MYX-0211/rs485-gateway/README.md

# RS485 多传感器环境监测网关（STM32F407 + FreeRTOS）

基于 **STM32F407VGT6** 的工业 RS485 总线数据采集网关：以 **Modbus RTU 主站**轮询总线上的光照 / 温湿度传感器，经 **FreeRTOS 多任务**调度完成采集、显示、越限报警，并通过 **ESP-01S Wi-Fi** 接入 **MQTT（EMQX）** 上报与接收远程指令，支持 **OTA 双区固件升级**，是一套完整的嵌入式「采集 → 处理 → 交互 → 上云 → 可远程升级」工程实践。

     

> 配套作品：[pid-gateway](https://github.com/MYX-0211/pid-gateway)（电机 PID 速度闭环 + CAN 双向）——两项目形成「采集上云 + 实时控制」互补，覆盖工控常见双链路。

**English Overview**: FreeRTOS-based industrial RS485/Modbus-RTU sensor gateway on STM32F407VGT6 — polls lux/temp-humidity sensors over a half-duplex bus (DMA + idle-line framing, CRC16), drives OLED/key/buzzer, reports JSON over MQTT (EMQX) via an ESP-01S Wi-Fi module, accepts remote threshold commands, and supports OTA firmware upgrade with a dual-region bootloader plus external SPI-flash staging.

<p align="center">
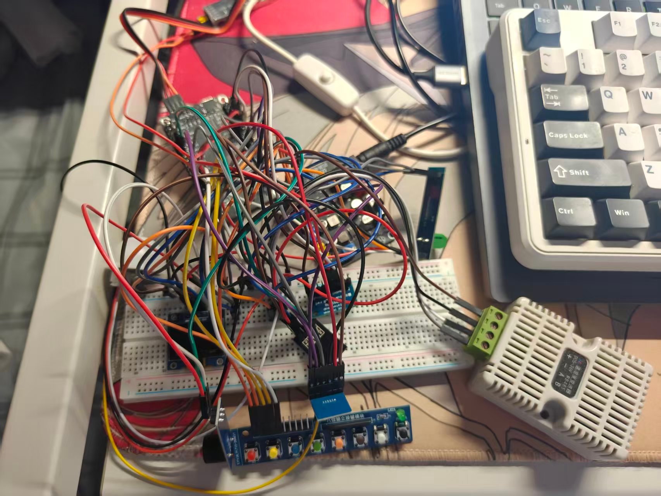
[picture p1: assets/screenshots/hardware_wiring.jpg]
RS485 网关实物接线：STM32F407 核心板 + MAX485 + OLED + ESP-01S + 温湿度传感器
  
</p>
<p align="center"><em>实物接线 —— 面包板上的完整链路：STM32F407 核心板 / MAX485 收发 / SSD1306 OLED / ESP-01S / 两路 RS485 传感器</em></p>

## 目录

- [系统架构](#系统架构)
- [功能特性](#功能特性)
- [硬件清单](#硬件清单)
- [软件设计要点](#软件设计要点)
- [MQTT 数据协议](#mqtt-数据协议)
- [OTA 固件升级](#ota-固件升级)
- [工程结构](#工程结构)
- [环境与构建](#环境与构建)
- [运行配置](#运行配置)
- [运行效果与实拍](#运行效果与实拍)
- [许可证](#许可证)

## 系统架构

```mermaid
flowchart TB
    subgraph BUS["RS485 总线 · USART1 + MAX485 · 9600 8N1"]
        direction LR
        S1["光照传感器<br/>B-RS-L30 · 地址 0x01"]
        S2["温湿度传感器<br/>HKDZ-SHT30 · 地址 0x02"]
    end

    MCU["STM32F407VGT6 @168MHz<br/>FreeRTOS V11.1.0"]

    subgraph TASKS["FreeRTOS 任务（数字为优先级）"]
        direction TB
        T1["vTaskSensor · 3 · 1s<br/>Modbus 轮询 → 报警判定 → 入队"]
        T2["vTaskLED · 2 · 200ms<br/>报警时三灯轮闪"]
        T3["vTaskNet · 1 · 5s<br/>MQTT 上报 / OTA 接收"]
        T4["vTaskOLED · 1 · 200ms<br/>Peek 最新帧刷新显示"]
        T5["vTaskKey · 1 · 10ms<br/>消抖 + 边沿检测"]
    end

    Q[("队列 深 1<br/>xQueueOverwrite")]
    OLED["SSD1306 OLED<br/>I2C1 · 400kHz"]
    ALARM["有源蜂鸣器 + 3×LED"]
    ESP["ESP-01S<br/>USART3 · 115200"]
    W25["W25Q64<br/>SPI1"]
    CLOUD["EMQX Broker<br/>Wi-Fi / TCP 1883"]

    S1 --> BUS
    S2 --> BUS
    BUS --> MCU
    MCU --> TASKS
    T1 --> Q
    Q --> T3
    Q --> T4
    T1 --> ALARM
    T2 --> ALARM
    T4 --> OLED
    T5 --> T4
    T3 --> ESP
    T3 --> W25
    ESP <-->|"JSON 上行 / 指令下行"| CLOUD
    CLOUD -.->|"OTA 固件下发（经 PC TCP:9000）"| W25

    style MCU fill:#dae8fc,stroke:#6c8ebf
    style Q fill:#fff2cc,stroke:#d6b656
    style CLOUD fill:#d5e8d4,stroke:#82b366
```

**串口资源分配**

| 外设 | 引脚 | 波特率 | 用途 |
|---|---|---|---|
| USART1 + MAX485 | PA9/PA10（DE=PA8） | 9600 8N1 | RS485 总线（Modbus RTU） |
| USART2 | PA2/PA3 | 115200 8N1 | printf 调试输出 |
| USART3 | PB10/PB11 | 115200 8N1 | ESP-01S Wi-Fi 模块 |
| I2C1 | PB6(SCL)/PB7(SDA) | 400kHz | SSD1306 OLED (0x78) |

## 功能特性

- **Modbus RTU 主站协议**：手写 CRC16-Modbus 校验；`0x03` 读保持寄存器完整事务（组帧 → 中断发送 → 空闲中断判帧接收 → 校验 → 大端解析），带完整错误码区分（无响应 / CRC 错 / 异常帧 / 地址不符）
- **RS485 半双工驱动**：DMA + 空闲中断（`HAL_UARTEx_ReceiveToIdle_DMA`）自动判帧，天然满足 Modbus RTU 3.5 字符帧间隔；DE 方向在 TC 中断精确切换，保证末位数据完整
- **FreeRTOS 多任务**：采集（最高优先级）/ LED 指示 / OLED 显示 / 按键 / 网络上报 五任务；采集任务以 `vTaskDelayUntil` 实现 1s 不漂移周期
- **任务间通信与同步**：深 1 队列 + `xQueueOverwrite` 广播最新数据帧；互斥锁保护 RS485 总线与 printf 输出；信号量实现发送/接收完成同步（含 ISR 安全释放）
- **温度越限报警**：三态判定 + 回差（hysteresis）防抖，按键可在线调节阈值并落 OLED 设置页
- **ESP-01S Wi-Fi 上报**：AT 指令完整状态机（退出透传 → 复位 → 探测 → STA 配网 → TCP 连接），UART 丢字节环境下健壮的多关键字匹配与安全重试
- **MQTT 双向通信**：经 ESP-01S 接入 EMQX，上行 5s 周期上报 JSON（光照/温湿度/报警），下行订阅 `rs485gw/cmd` 接收阈值设置与查询指令
- **OTA 固件升级**：Bootloader + 双区切换 + 外部 SPI Flash 暂存，CRC16 整包校验与回读校验，校验失败自动保持旧固件运行
- **参数掉电保存**：报警阈值写入外部 Flash 参数区，采用日志式追加写（避免频繁擦除），上电自动加载
- **工业传感器解析**：按厂商特殊编码解析温度（非标准 int16 补码），32 位光照跨寄存器大端合并；温湿度经 `0x04` 读输入寄存器

## 硬件清单

| 器件 | 型号/参数 | 说明 |
|---|---|---|
| 主控 | STM32F407VGT6 | 168MHz，1MB Flash / 192KB RAM |
| 总线收发 | MAX485 | RS485 半双工，PA8 方向控制 |
| 光照传感器 | B-RS-L30（Modbus，地址 0x01） | 寄存器 0x0002，32 位值 ÷1000 = Lux |
| 温湿度传感器 | HKDZ-SHT30-RS（Modbus，地址 0x02） | 寄存器 0x0000/0x0001，厂商特殊编码 |
| Wi-Fi 模块 | ESP-01S（ESP8266） | STA 模式，TCP Client |
| 外部 Flash | W25Q64（8MB SPI NOR） | OTA 固件暂存 + 参数区，SPI1（PB3/PB4/PB5，CS=PA4） |
| 显示 | SSD1306 OLED 0.96" | I2C，4 行 × 16 字符 |
| 交互 | 按键 ×3 / 有源蜂鸣器 / LED ×3 | 阈值调节、报警指示 |

## 软件设计要点

**任务划分与数据流**

| 任务 | 优先级 | 周期 | 职责 |
|---|---|---|---|
| `vTaskSensor` | 3 | 1s（绝对节拍） | RS485 总线锁内轮询两路传感器 → 报警判定 → 打包入队 |
| `vTaskLED` | 2 | 200ms | 报警时三灯轮闪 |
| `vTaskNet` | 1 | 5s | 取最新帧，经 ESP-01S TCP 上报；断线后台重连 |
| `vTaskOLED` | 1 | 200ms | Peek 最新帧刷新显示；设置页显示阈值调节界面 |
| `vTaskKey` | 1 | 10ms | 消抖 + 边沿检测，KEY1 切设置页 / KEY2/3 调阈值 |

**体现工程能力的关键处理**

- **RS485 总线互斥**：Modbus 事务全程持锁，锁内只做单次最短事务、锁外重试，避免与后续 Shell 等总线使用者冲突
- **HAL timebase 修复**：CubeMX 生成的 TIM6 中断未在 NVIC 使能，曾导致 `HAL_Delay` 卡死；手动「清 pending → 优先级 0 → 使能」根治（该中断不触碰任何 RTOS API，优先级 0 安全）
- **printf 重定向加锁**：`fputc` 经互斥锁串行化到 UART2，多任务并发打印不交错；调度器启动前自动降级裸发
- **栈与堆防护**：使能 `configCHECK_FOR_STACK_OVERFLOW` 与 malloc 失败钩子，爆栈/堆耗尽时打印任务名并停机，便于定位
- **ESP 初始化异步化**：配网与 TCP 重试（最坏数十秒）放入 `vTaskNet` 后台执行，调度器与 OLED 立即启动，不被网络阻塞
- **ESP 接收通道改造**：早期逐字节阻塞轮询在高优先级任务抢占时会丢字节（USART 无 FIFO，1ms 内可到 11 字节）。改为 DMA + 空闲中断 + 信号量后彻底解决，并补上错误恢复回调（`HAL_UART_ErrorCallback` 未实现时通道会永久静默）
- **OTA 顺序设计**：先在外部 Flash 暂存区完整收齐并校验通过，才动 APP 区 —— 任何时刻断电，至少有一份完整固件；搬运中断也能在下次上电自动重试

## MQTT 数据协议

设备经 ESP-01S 接入 EMQX，用两个主题完成双向通信：

| 主题 | 方向 | QoS | 说明 |
|---|---|---|---|
| `rs485gw/data` | 上行（设备 → 服务端） | 0 | 5 s 周期数据上报，同时承载指令回执 `ack` |
| `rs485gw/cmd` | 下行（服务端 → 设备） | 0 | 阈值设置 / 状态查询 / OTA 触发 |

**上行数据字段**

| 字段 | 类型 | 含义 |
|---|---|---|
| `seq` | uint | 帧序号自增，服务端据此判缺帧 / 重帧（断网补传的前置条件）|
| `up` | uint | 设备自开机毫秒数，用于判断数据新鲜度，与 `seq` 互相印证 |
| `lux` | float | 光照度（Lux）|
| `temp` | float | 温度（℃）|
| `humi` | float | 湿度（%RH）|
| `alarm` | 0 / 1 | 温度越上限报警标志（湿度只采集上报，不参与判定）|

**下行命令**

| 命令 | 回执 | 说明 |
|---|---|---|
| `{"cmd":"set_hi","v":30.0}` | `{"ack":"set_hi","hi":30.0}` | 远程修改报警上限，越界自动钳位；回差同步为 `v - 1.0`，并走与按键同一条掉电保存路径 |
| `{"cmd":"get"}` | `{"ack":"get","hi":…,"lux":…,"temp":…,"humi":…,"alarm":…}` | 查询当前阈值与最新一帧数据，改完可立刻回读，形成闭环验证 |
| `{"cmd":"ota_recv"}` | 串口打印 `STAGED OK` | 断开 MQTT → 连接 PC 的 `TCP:9000` 接收固件 → 校验通过后复位，由 Bootloader 搬运 |
| `{"cmd":"ota"}` / `{"cmd":"ota_bad"}` | `{"ack":"ota","r":0}` | OTA 自测：把当前 APP 写入暂存区；`ota_bad` 故意写错 CRC，用于验证「校验不过时拒绝搬运、旧固件照常运行」 |

> 未识别命令只打印日志并忽略，非法输入不会影响设备运行。`set_hi` 与按键任务可能并发写同一阈值，本工程按「最后写入者胜」处理：两侧都只做「赋值 + 钳位」而不做读-改-写，且 float 单次写入在 Cortex-M4 上是原子的，不会出现撕裂值。

**MQTTX 收发实测**（上行 5 s 一条、`seq` 连续；底部为下行 `ota_recv` 指令）

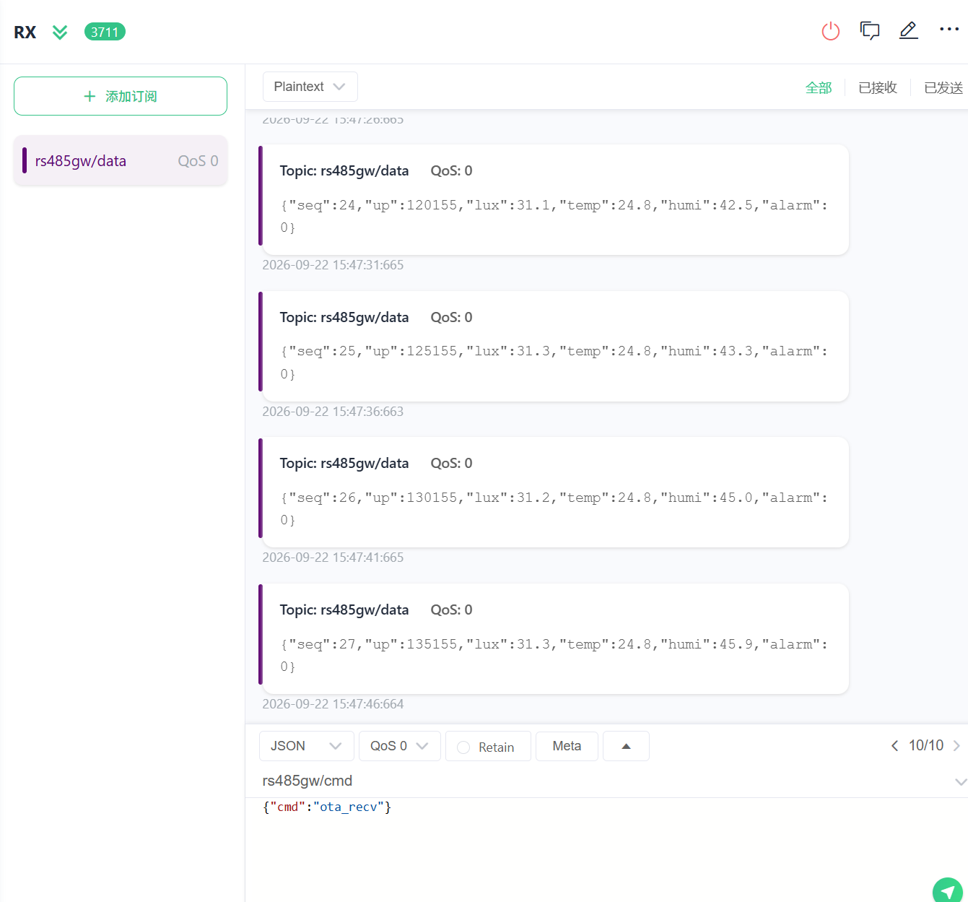
[picture p2: assets/screenshots/mqttx_report.png]
MQTTX 收发实测


## OTA 固件升级

采用 **Bootloader 双区 + 外部 Flash 暂存** 方案，全程约 11 秒（48 KB 固件）。

### 升级时序

```mermaid
sequenceDiagram
    autonumber
    participant PC as PC端 ota_sender.py
    participant ESP as ESP-01S
    participant APP as APP (vTaskNet)
    participant FL as W25Q64 暂存区
    participant BOOT as Bootloader

    Note over APP: 收到 MQTT 的 ota_recv 指令
    APP->>ESP: AT+MQTTDISCONNECT（与 MQTT 分时复用）
    APP->>FL: 整区擦除（64 KB 块擦，约 1.2 s）
    APP->>ESP: AT+CIPSTART 连接 PC:9000
    PC-->>ESP: TCP 建连
    loop 逐行下发 hex 编码固件
        PC->>ESP: hex 数据行 + CRLF
        ESP->>APP: +IPD 数据帧
        APP->>APP: 跳过前缀 → hex 解码 → 累加 CRC16
        APP->>FL: 写入暂存区
    end
    PC->>APP: 结束帧 END size crc
    APP->>APP: 比对字节数与整包 CRC
    APP->>FL: 回读校验 → 写头部（magic/fw_size/fw_crc/ver）
    Note over APP: 提示后由用户复位

    Note over BOOT: 复位后由 Bootloader 接管
    BOOT->>FL: 读头部
    BOOT->>FL: 校验整包 CRC
    alt CRC 通过
        BOOT->>BOOT: 擦 APP 区 → 按扇区搬运 → 回读校验
        BOOT->>FL: 清除升级标志
        BOOT->>APP: 跳转到 APP 执行
    else CRC 不通过
        BOOT->>APP: 直接跳转（旧固件照常运行）
    end
```

### Flash 分区

```mermaid
flowchart LR
    subgraph MCU["STM32F407 内部 Flash · 1 MB"]
        direction TB
        B["Bootloader<br/>0x08000000<br/>64 KB"]
        A["APP<br/>0x08010000<br/>704 KB"]
        U["未使用"]
    end

    subgraph W25["W25Q64 外部 SPI Flash · 8 MB"]
        direction TB
        S["固件暂存区<br/>0x000000<br/>1 MB"]
        K["备份区（预留）<br/>0x100000<br/>1 MB"]
        R["未使用"]
    end

    PC["PC<br/>ota_sender.py"] -->|"TCP 下发"| S
    S -->|"Bootloader 搬运"| A
    B -->|"校验通过后跳转"| A

    style B fill:#ffe6cc,stroke:#d79b00
    style A fill:#d5e8d4,stroke:#82b366
    style S fill:#dae8fc,stroke:#6c8ebf
    style K fill:#f5f5f5,stroke:#999999
    style R fill:#f5f5f5,stroke:#999999
    style U fill:#f5f5f5,stroke:#999999
```

| 区域 | 地址 | 大小 | 用途 |
|---|---|---|---|
| Bootloader | `0x08000000` | 64 KB | 升级搬运（裸机，不复用 APP 代码）|
| APP | `0x08010000` | 704 KB | 应用固件 |
| W25Q64 暂存区 | `0x000000` | 1 MB | 待搬运的新固件 |
| W25Q64 备份区 | `0x100000` | 1 MB | 预留（回滚用）|

**关键设计**

- **升级期间不影响运行**：固件先落在外部 SPI Flash，不占用内部 Flash —— 写入期间 APP 照常采集上报
- **刷坏不变砖**：暂存区校验不通过时 Bootloader 不碰 APP 区，旧固件继续运行
- **顺序保证**：擦除在开始接收之前一次性完成（擦内部 Flash 时同 Bank 取指 stall，边收边擦会丢帧）
- **回读校验**：搬运后把 APP 区读回来重新算 CRC，不依赖"写入成功"的返回值

**使用方法**

```bash
# 0. 先生成待下发的固件 bin（Doc/*.bin 不入库，需本地自行导出）
fromelf --bin --output=Doc/app_v1.bin MDK-ARM/rs485_gateway/rs485_gateway.axf

# 1. PC 上启动下发脚本（监听 9000）
python tools/ota_sender.py Doc/app_v1.bin
#    或直接双击 tools/run_ota_sender.bat（自动探测可用 Python，缺省发送 Doc/app_v1.bin）

# 2. 设备收到 MQTT 指令后断开 MQTT、连上 PC 并接收固件
#    MQTTX 向 rs485gw/cmd 发布： {"cmd":"ota_recv"}

# 3. 接收完成并校验通过后复位，Bootloader 自动搬运并跳转
```

> `fromelf` 随 Keil MDK 一同安装；也可在 Keil 的 Target Options → User → After Build 中挂上该命令，编译后自动导出 bin。

**实测性能**（48 KB 固件）

| 环节 | 耗时 |
|---|---|
| 擦除暂存区 704 KB（64 KB 块擦）| ≈ 1.2 s |
| 接收 48 KB（hex over UART @115200）| ≈ 8.7 s |
| Bootloader 校验 + 擦 APP 扇区 + 搬运 + 回读 | ≈ 1.0 s |
| **设备侧合计** | **≈ 11 s** |

> 接收环节受 UART 速率限制（hex 编码使传输量翻倍）；如需提速可提高 USART3 波特率或改用二进制传输。

### 串口实测日志

一次完整的 OTA 升级（48 KB 固件，`ver=2`）：PC 侧 TCP 建连后约 8.8 s 收完，回读 CRC 与接收 CRC 完全一致，暂存落盘成功后才提示复位。

```text
[OTA] disconnecting MQTT before TCP transfer...
[OTA] erasing stage area (704 KB)...
[OTA] stage erased
[OTA] TCP connected to 192.168.1.100:9000, receiving...
[OTA] recv 8192 B
[OTA] recv 16384 B
[OTA] recv 24576 B
[OTA] recv 32768 B
[OTA] recv 40960 B
[OTA] recv 49152 B
[OTA] END frame: size=49152 crc=0x6F75
[OTA] readback crc=0x6F75 recv crc=0x6F75
[OTA] recv done: got 49152 B, exp 49152 B; crc got 0x6F75 exp 0x6F75
[OTA] STAGED OK: size=49152 crc=0x6F75 ver=2 -> reboot to apply
[OTA] TCP closed
[OTA] recv result=0, MQTT will reconnect
[ESP] reconnecting...
```

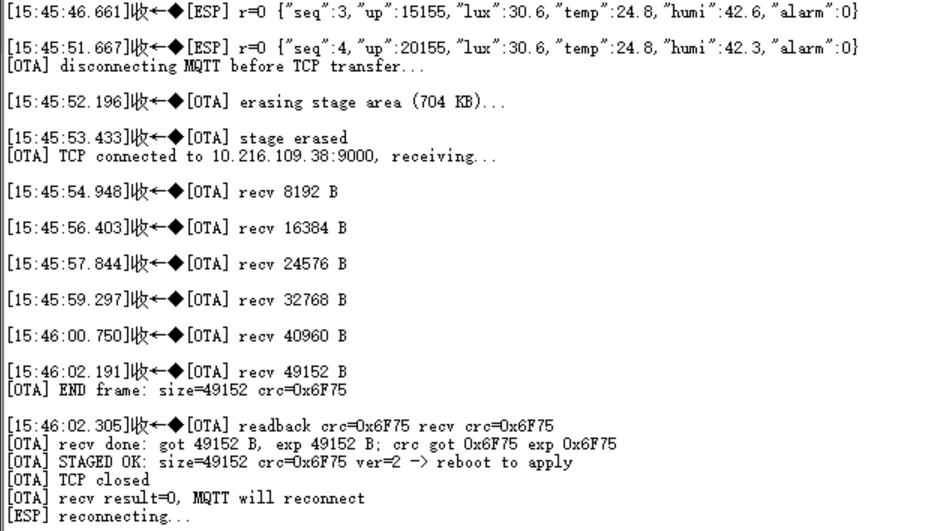
[picture p3: assets/screenshots/ota_uart_log.png]
OTA 升级串口日志


## 工程结构

```
rs485_gateway/
├── Bootloader/
│   └── boot_main.c             # OTA Bootloader（裸机，双区升级搬运）
├── Core/                       # 应用代码（CubeMX + 自研）
│   ├── Inc/
│   │   ├── main.h              # 引脚宏定义（按键/LED/RS485/蜂鸣器）
│   │   ├── modbus.h            # Modbus RTU 主站接口
│   │   ├── rs485.h             # RS485 半双工驱动接口
│   │   ├── esp01s.h            # ESP-01S Wi-Fi 驱动接口
│   │   ├── w25q64.h / spi.h    # 外部 SPI Flash 驱动 / SPI1 初始化
│   │   ├── param.h             # 报警阈值掉电保存
│   │   ├── ota.h               # OTA 共享定义（分区/头部结构/CRC16）
│   │   ├── oled.h / oledfont.h # SSD1306 驱动 / 8×16 字库
│   │   └── FreeRTOSConfig.h    # FreeRTOS 裁剪配置
│   └── Src/
│       ├── main.c              # 应用层：任务创建 + 业务逻辑 + OTA 接收
│       ├── modbus.c            # CRC16 + 寄存器读事务（0x03 / 0x04）
│       ├── rs485.c             # UART+DMA 收发、方向切换、回调
│       ├── esp01s.c            # AT 指令状态机、TCP 上报、MQTT、取流接口
│       ├── w25q64.c / spi.c    # Flash 读写擦除 / SPI1 外设
│       ├── param.c             # 参数区日志式追加写
│       ├── oled.c              # OLED 底层 I2C 时序
│       └── usart.c / i2c.c ... # CubeMX 外设初始化
├── FreeRTOS/                   # FreeRTOS V11.1.0 精简内核
│   ├── Inc/                    # 内核头文件
│   └── Src/                    # list/tasks/queue/port/heap_4 等
├── Drivers/                    # CMSIS + STM32F4xx HAL 库
├── tools/                      # PC 侧辅助脚本
│   ├── ota_sender.py           # OTA 固件下发（PC 侧 TCP Server）
│   ├── run_ota_sender.bat      # 双击启动器（自动探测可用的 Python 解释器）
│   ├── after_cubemx.py         # CubeMX 重新生成后的配置恢复脚本
│   ├── check_printf_ascii.py   # 校验 printf 字面量不含非 ASCII（AC5 按 GBK 解析源码）
│   └── strip_ai_comment_style.py # 清理 C 注释里的 Markdown / emoji 残留
├── Doc/
│   └── debug-log.md            # 调试复盘（6 条真实踩坑，已入库；其余手册/视频为本地资料）
├── assets/                     # 演示视频 + 运行实拍截图
│   ├── demo.mp4 / demo_cover.jpg
│   └── screenshots/            # 硬件接线 / OLED / MQTTX / OTA 串口日志
├── MDK-ARM/rs485_gateway.uvprojx   # Keil 工程（APP / BOOT 双 Target）
├── rs485_gateway.ioc           # CubeMX 配置（可重新生成）
├── LICENSE                     # MIT
└── README.md
```

## 环境与构建

| 工具 | 版本 | 说明 |
|---|---|---|
| Keil MDK | μVision5（工程按 **ARM Compiler 5 / AC5** 配置，`uAC6=0`） | 打开 `MDK-ARM/rs485_gateway.uvprojx` 直接编译 |
| STM32CubeMX | 任意支持 F4 的版本 | 可选：修改 `.ioc` 重新生成外设代码 |
| 烧录 | ST-Link / J-Link | Keil 下载按钮直接烧录 |

构建步骤：

1. 安装 Keil MDK5 与 STM32F4 器件支持包（Device Family Pack）
2. 打开 `MDK-ARM/rs485_gateway.uvprojx`
3. FreeRTOS 内核源码已内置于仓库（`FreeRTOS/`），无需额外安装或手动添加路径
4. 按需切换工程内两个 Target 分别编译：`rs485_gateway`（APP，`0x08010000`）与 `BOOT`（Bootloader，`0x08000000`）
5. 编译（F7）→ 下载（F8）→ 复位运行

> 注：工程为 CubeMX 生成结构，`Core` 中带有 `USER CODE` 标记的代码段可被 CubeMX 保留，便于后续重新生成外设代码。重新生成后如遇外设配置被覆盖，可参考 `tools/after_cubemx.py` 恢复。

## 运行配置

烧录前修改 `Core/Src/main.c` 顶部宏（仓库内均为占位符，不含任何真实凭据）：

```c
#define WIFI_SSID    "YOUR_SSID"       /* 2.4G 热点名（ESP-01S 只支持 2.4G，勿填 5G） */
#define WIFI_PWD     "YOUR_PASSWORD"   /* 热点密码 */
/* USE_MQTT=1 -> MQTT broker：填 PC 的 IP，由 PC 上的 portproxy 转发到 EMQX 虚拟机
 * USE_MQTT=0 -> 裸 TCP：填 PC 网络调试助手的地址，端口与助手的 TCPServer 一致 */
#define SERVER_IP    "192.168.1.100"   /* PC 在该网络下的 IP（换网络必须同步改，用 ipconfig 查） */
#if USE_MQTT
#define SERVER_PORT  1883              /* MQTT broker 端口 */
#else
#define SERVER_PORT  8000              /* PC 网络调试助手 TCPServer 端口 */
#endif
```

上报链路由 `Core/Inc/esp01s.h` 中的 `USE_MQTT` 开关切换（默认 `1` = 走 MQTT），三处端口用途不同、不要混淆：

| 用途 | 端口 | 定义位置 | 对端 |
|---|---|---|---|
| MQTT 上行 / 指令下行（`USE_MQTT=1`） | 1883 | `main.c` `SERVER_PORT` | EMQX broker |
| 裸 TCP 上报（`USE_MQTT=0`） | 8000 | `main.c` `SERVER_PORT` | PC 网络调试助手（TCP Server 模式） |
| OTA 固件下发 | 9000 | `main.c` `OTA_SRV_PORT` | PC `tools/ota_sender.py` |

- ESP-01S 仅支持 **2.4G** Wi-Fi；公共热点若需网页/短信认证（Portal）无法直连，请换普通热点
- 换网络后 `SERVER_IP` 需同步改为 PC 在该网络下的实际 IP；PC 端使用任意网络调试助手时必须开 **TCP Server 模式**、端口与 `SERVER_PORT` 一致
- 串口调试输出在 **UART2（115200 8N1）**；数据 5 s 一条，打印内容与 MQTT 上行 JSON 完全一致：
  ```
  [ESP] r=0 {"seq":3,"up":15155,"lux":30.6,"temp":24.8,"humi":42.6,"alarm":0}
  ```

> 调试复盘（timebase 卡死 / printf 加锁 / ESP 异步化等 6 条真实踩坑）见 [Doc/debug-log.md](Doc/debug-log.md)。

## 运行效果与实拍

**OLED 显示**（SSD1306，4 行 × 16 字符；正常页 200 ms 刷新，设置页由 KEY1 进入、KEY2/KEY3 调节）

| 正常页 | 阈值设置页 |
|---|---|
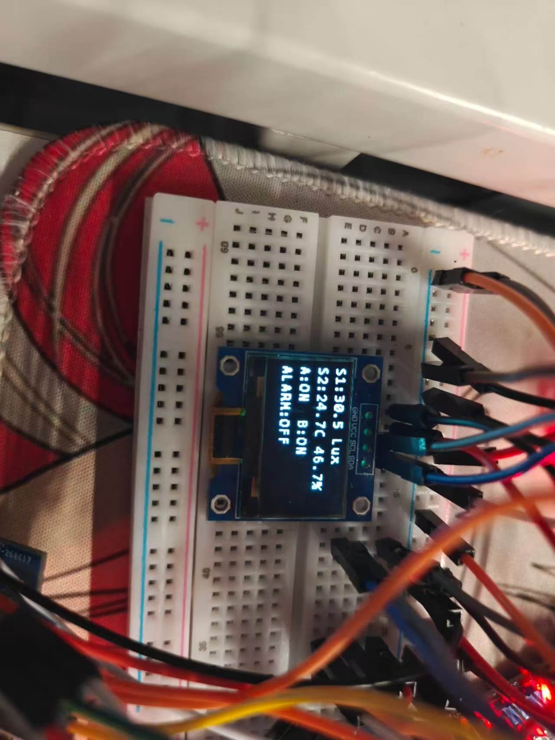
[picture p4: assets/screenshots/oled_display.jpg]
OLED 正常页显示光照与温湿度
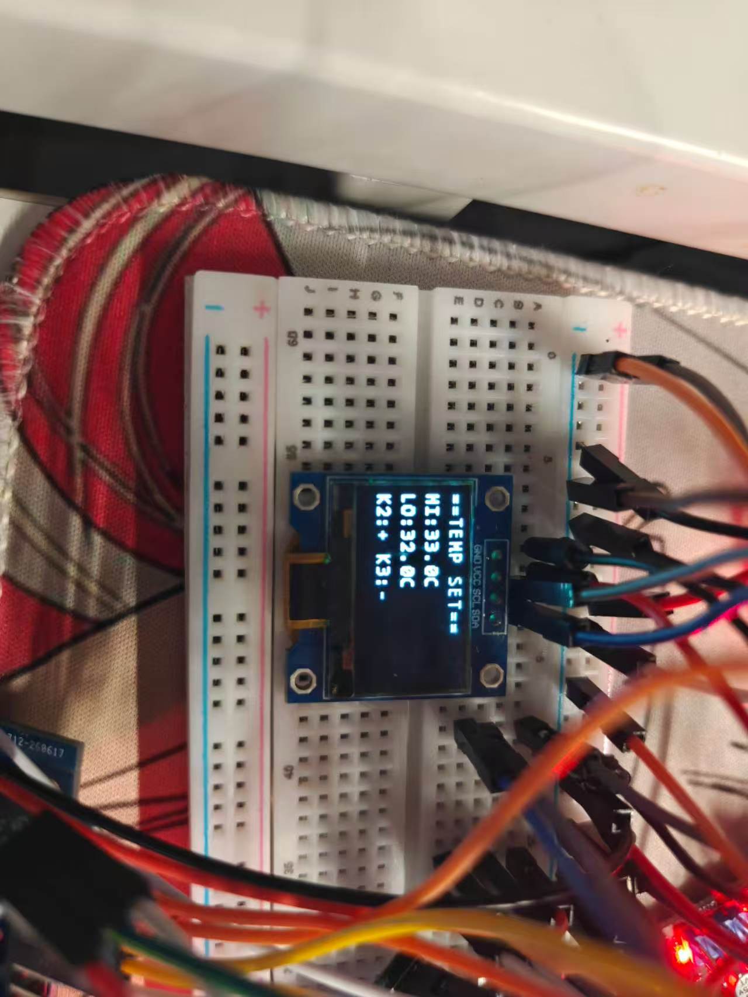
[picture p5: assets/screenshots/oled_threshold_setting.jpg]
OLED 温度阈值设置页
|  |  |
| `S1:30.5 Lux`<br>`S2:24.7C 46.7%`<br>`A:ON  B:ON`<br>`ALARM:OFF` | `==TEMP SET==`<br>`HI:33.0C`<br>`LO:32.0C`<br>`K2:+ K3:-` |

（左：光照/温湿度数值 + 两路在线状态 + 报警状态；右：报警上限 `HI` 与回差解除线 `LO` 相差 1.0℃，调节范围有上下界钳制）

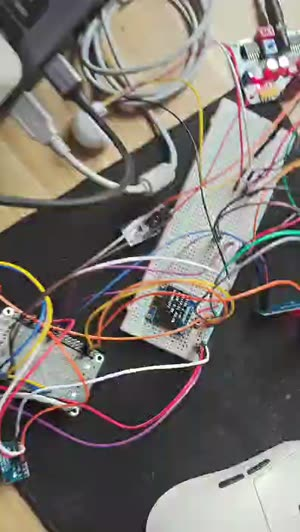
[picture p6: assets/demo_cover.jpg]
演示视频封面
[](assets/demo.mp4)

*点击封面跳转到视频文件页。GitHub 对较大体积（9.66 MB）的视频不直接预览，需下载到本地后用 VLC / PotPlayer / 系统播放器打开观看（2 分 22 秒）。*

- OLED 实时显示两路传感器数值与在线状态，报警时显示 `ALARM:ON`
- **温度越上限报警**（仅温度参与判定，湿度只采集上报）→ 蜂鸣器响 + 三灯 200ms 轮闪；低于回差解除线（上限 −1℃）自动复位
- KEY1 进入设置页，KEY2/KEY3 调节温度报警上限（0.5℃ 步进，调节范围有上下界钳制）；也可由 MQTT `set_hi` 远程修改，两者共用同一条参数落盘路径，掉电不丢

## 许可证

本项目基于 [MIT License](LICENSE) 开源，可自由用于学习、修改与二次开发（保留版权声明即可）。

---

*个人作品，用于嵌入式软件岗位求职展示。演示视频见 [assets/demo.mp4](assets/demo.mp4)，运行实拍截图见 [assets/screenshots](assets/screenshots)，调试复盘见 [Doc/debug-log.md](Doc/debug-log.md)；传感器与模块手册等第三方本地资料未随仓库分发（`Doc/` 除 `debug-log.md` 外已在 `.gitignore` 排除）。*
