MYX-0211/rs485-gateway/Core/Inc/main.h

#define KEY2_Pin GPIO_PIN_2
#define KEY2_GPIO_Port GPIOE
#define KEY1_Pin GPIO_PIN_3
#define KEY1_GPIO_Port GPIOE
#define KEY3_Pin GPIO_PIN_4
#define KEY3_GPIO_Port GPIOE
#define W25Q64_CS_Pin GPIO_PIN_4
#define W25Q64_CS_GPIO_Port GPIOA
#define LED1_Pin GPIO_PIN_10
#define LED1_GPIO_Port GPIOD
#define LED2_Pin GPIO_PIN_13
#define LED2_GPIO_Port GPIOD
#define LED3_Pin GPIO_PIN_14
#define LED3_GPIO_Port GPIOD
#define RS485_DE_Pin GPIO_PIN_8
#define RS485_DE_GPIO_Port GPIOA
#define BUZZER_Pin GPIO_PIN_5
#define BUZZER_GPIO_Port GPIOB
#define LED_ON   GPIO_PIN_SET     /* LED 点亮电平：高电平亮（板载三色灯，低电平灭） */
#define LED_OFF  GPIO_PIN_RESET
