MYX-0211/rs485-gateway/Core/Inc/oledfont.h

#ifndef __OLEDFONT_H
#define __OLEDFONT_H

/* 8x16 ASCII font, char index = ascii - 32
 * each char 16 bytes: [0..7]=upper page col0..7, [8..15]=lower page, LSB=top pixel */
const unsigned char F8X16[95 * 16] = {
  0x00,0x00,0x00,0x00,0x00,0x00,0x00,0x00,0x00,0x00,0x00,0x00,0x00,0x00,0x00,0x00, /* ' ' */
  0x00,0x00,0x00,0xBE,0x80,0x00,0x00,0x00,0x00,0x00,0x00,0x01,0x01,0x00,0x00,0x00, /* '!' */
  0x00,0x00,0x0E,0x00,0x0E,0x00,0x00,0x00,0x00,0x00,0x00,0x00,0x00,0x00,0x00,0x00, /* '"' */
  0x48,0xE8,0x5E,0xE8,0x5E,0x48,0x00,0x00,0x00,0x01,0x00,0x01,0x00,0x00,0x00,0x00, /* '#' */
  0x00,0x0C,0x92,0x7F,0x22,0xC0,0x00,0x00,0x00,0x01,0x03,0x01,0x01,0x00,0x00,0x00, /* '$' */
  0x1E,0x92,0x5E,0xF0,0x28,0xE4,0x02,0x00,0x01,0x00,0x00,0x01,0x01,0x01,0x00,0x00, /* '%' */
  0xC0,0x2C,0x12,0x72,0xCE,0xE0,0x00,0x00,0x00,0x01,0x01,0x01,0x01,0x01,0x01,0x00, /* '&' */
  0x00,0x00,0x00,0x0E,0x00,0x00,0x00,0x00,0x00,0x00,0x00,0x00,0x00,0x00,0x00,0x00, /* '\'' */
  0x00,0x00,0xF8,0x06,0x01,0x00,0x00,0x00,0x00,0x00,0x00,0x03,0x04,0x00,0x00,0x00, /* '(' */
  0x00,0x00,0x01,0x06,0xF8,0x00,0x00,0x00,0x00,0x00,0x04,0x03,0x00,0x00,0x00,0x00, /* ')' */
  0x00,0x14,0x18,0x3E,0x18,0x14,0x00,0x00,0x00,0x00,0x00,0x00,0x00,0x00,0x00,0x00, /* '*' */
  0x00,0x20,0x20,0xF8,0x20,0x20,0x00,0x00,0x00,0x00,0x00,0x00,0x00,0x00,0x00,0x00, /* '+' */
  0x00,0x00,0x80,0x80,0x00,0x00,0x00,0x00,0x00,0x04,0x07,0x03,0x00,0x00,0x00,0x00, /* ',' */
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
  0x00,0xFE,0x12,0x12,0x12,0x00,0x00,0x00,0x00,0x01,0x01,0x01,0x01,0x00,0x00,0x00, /* 'E' */
  0x00,0xFE,0x12,0x12,0x12,0x00,0x00,0x00,0x00,0x01,0x00,0x00,0x00,0x00,0x00,0x00, /* 'F' */
  0x78,0x84,0x02,0x12,0x12,0xF2,0x00,0x00,0x00,0x00,0x01,0x01,0x01,0x01,0x00,0x00, /* 'G' */
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
};

#endif
