MYX-0211/rs485-gateway/(commit log)

2026-09-03 Initial commit: RS485 multi-sensor gateway on STM32F407 + FreeRTOS
    - Modbus RTU master over RS485 (DMA + idle-line framing, CRC16)
    - FreeRTOS tasks: sensor polling / OLED / LED alarm / key / Wi-Fi report
    - ESP-01S AT driver with robust multi-keyword matching and safe retry
    - Temperature threshold alarm with hysteresis, key adjustable
    - CubeMX HAL project, Keil MDK ready, sensor config sanitized
2026-09-03 docs: 修正报警描述——仅温度越上限触发报警（湿度不参与判定）
2026-09-03 docs: README 嵌入可点击演示视频（assets/demo.mp4 + 封面图）
2026-09-03 docs: 修正视频播放说明——GitHub 不预览大体积视频，需下载后本地播放
2026-09-03 docs: 修正 main.c 三处注释——报警仅温度越上限判定（湿度不参与）
    [main.c]
2026-09-05 Add cross-link to companion pid-gateway repo
2026-09-21 feat: OTA 双区升级 + W25Q64 驱动 + MQTT 双向通信
    新增
    - OTA 双区升级：Bootloader(0x08000000) + APP(0x08010000) 双 Target，
    外部 SPI Flash 暂存固件，CRC16 整包校验 + 回读校验 + 断电保护
    - W25Q64 SPI Flash 驱动（JEDEC ID 校验 / 页编程 / 扇区与块擦除）
    - PC 侧 tools/ota_sender.py 经 TCP 下发固件，APP 收包写入暂存区
    - 报警阈值掉电保存（参数区日志式追加写，避免频繁擦除）
    - MQTT 双向通信：EMQX 上行 JSON 与下行指令
    变更
    - 温湿度传感器改用 0x04 读输入寄存器
    - ESP-01S 接收通道改为 DMA + 空闲中断 + 信号量，补错误恢复回调
    文档
    - README 补充 OTA 章节、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
2026-09-22 docs: README 新增 Mermaid 架构图与 OTA 升级图
    - 系统架构：ASCII 图替换为 Mermaid 流程图，直观展示
    传感器总线、FreeRTOS 任务优先级、队列数据流与外设连接
    - OTA 章节：新增升级时序图（sequenceDiagram），
    含正常升级与校验失败两条分支路径
    - OTA 章节：新增 Flash 分区图，展示内部 Flash 与
    W25Q64 各区块的地址、大小及搬运/跳转关系
    - 修正目录锚点与章节标题的对应关系
2026-09-22 docs: 新增运行实拍截图并补充 MQTT 协议章节
    - 新增 assets/screenshots/：硬件接线、OLED 正常页与设置页、MQTTX 收发实测、OTA 串口日志
    - README 新增「MQTT 数据协议」章节：主题/QoS、上行 JSON 字段表、下行命令与 ack 回执
    - OTA 章节补充一次完整升级的串口实测日志（48 KB 固件，ver=2，CRC 回读一致）
    - 运行效果改为「运行效果与实拍」，用实拍图佐证 OLED 显示内容
    - 修正运行配置中的串口打印示例为真实 JSON 格式；工程结构补充 assets/ 目录
    - README 行尾规范化：原 blob 为 CR CR LF 双重转换，统一为标准 LF
2026-09-22 chore: 整理仓库——README 补充 MQTT/OTA 与许可证章节、凭据改为占位符、OTA 启动器跨机兼容、移除个人规划文档
